oh7bf/RasPiPwrSwitch/raspipwrswitch.png

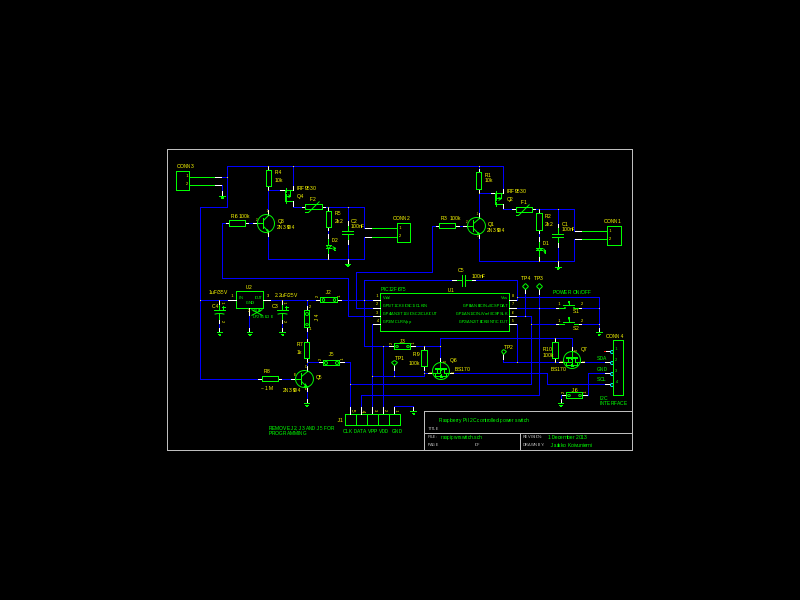
raspipwrswitch.png
