oh7bf/RasPiPwrSwitch/raspipwrswitch.pdf

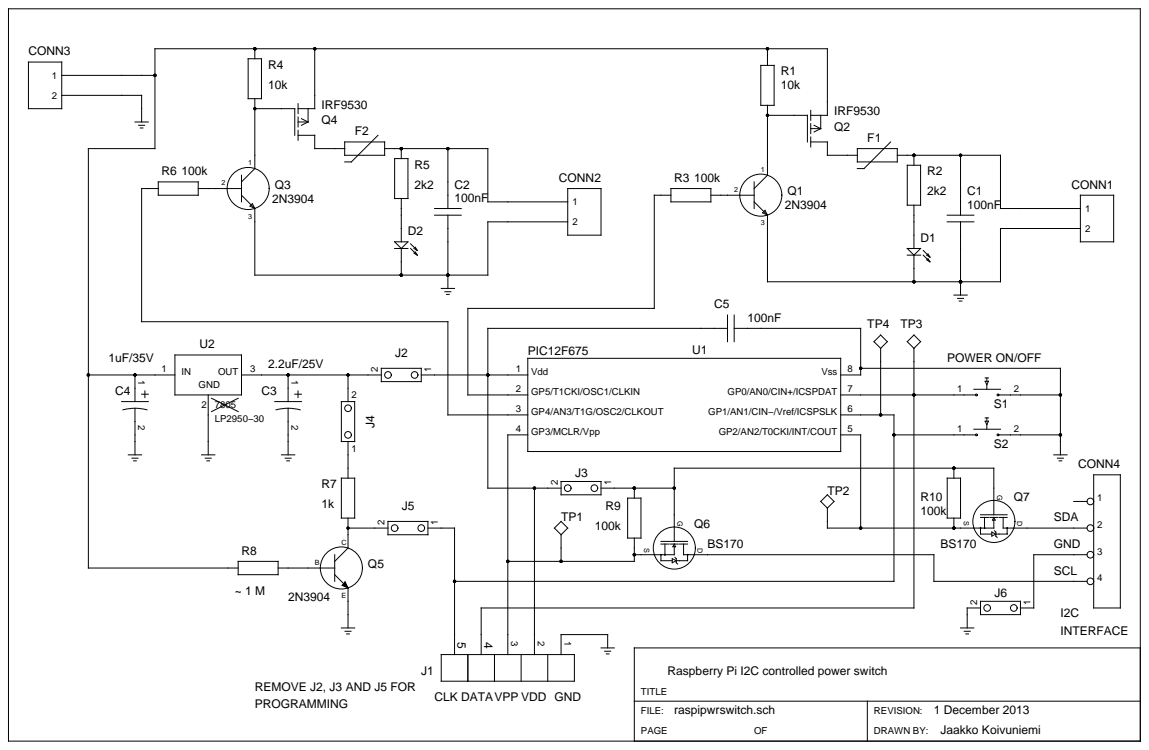
[picture p3: page 1]

Raspberry Pi I2C controlled power switch
