oh7bf/RasPiPwrSwitch/board_mirror.pdf

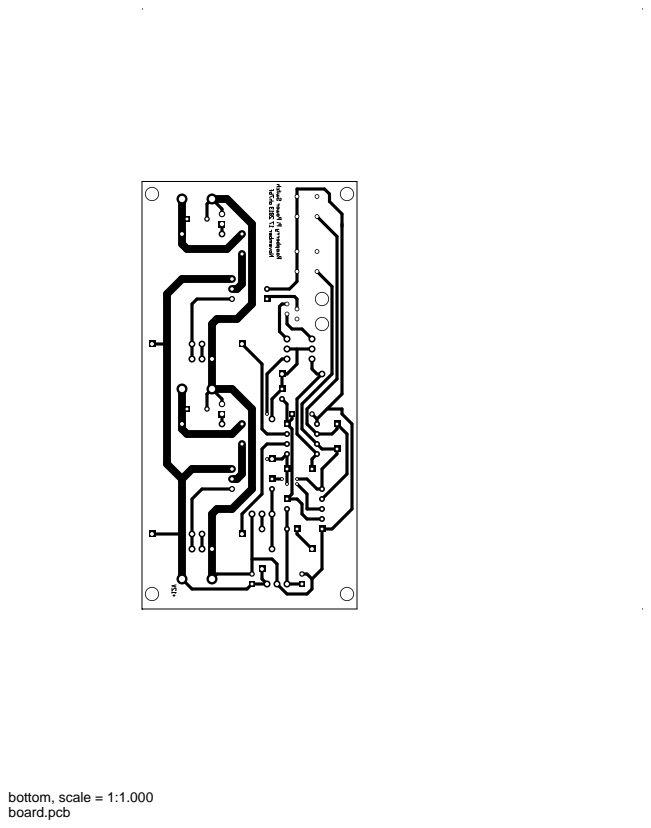
[picture p4: page 1]
board.pcb; bottom, scale = 1:1.000
