oh7bf/RasPiPwrSwitch/board_silk_mirror.pdf

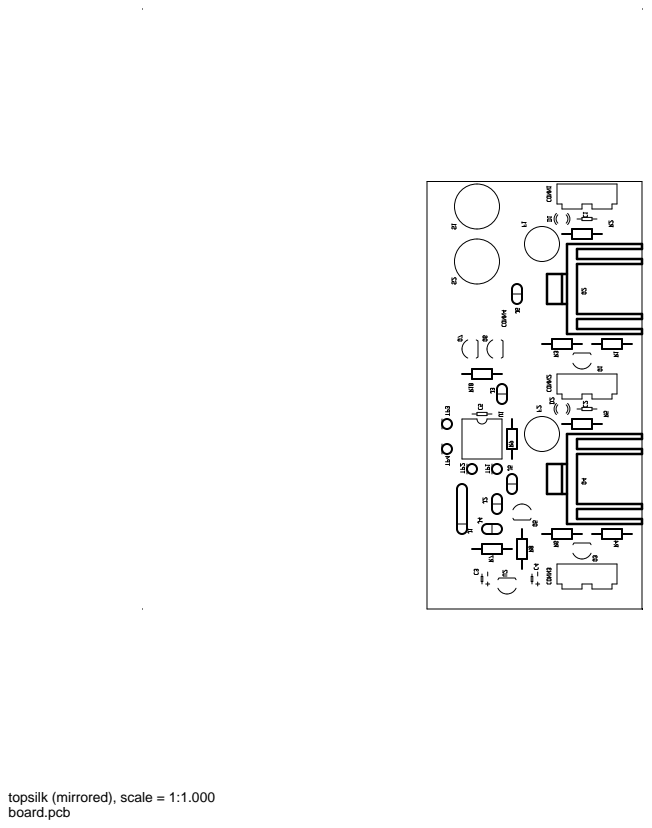
[picture p5: page 1]

topsilk (mirrored), scale = 1:1.000
board.pcb
