oh7bf/RasPiPwrSwitch/(commit log)

2013-11-24 Initial commit.
    [raspipwrswitch.sch]
2013-12-01 Add part list to README and update schematics.
    [raspipwrswitch.sch]
2014-02-24 Update README.txt
    Add note on pipicswd(1) server and pipicsw(1) client for controlling
    the switch.
